satri360/vmuzero_seps525/README.md

# vmuzero_seps525
Dreamcast VMU powered by Raspberry Pi Zero Project
