satri360/vmuzero_seps525/vmuzero_SEPS525_V1_0_ICHG100.sch

## EAGLE design vmuzero_SEPS525_V1_0_ICHG100.sch (2018-01-29)

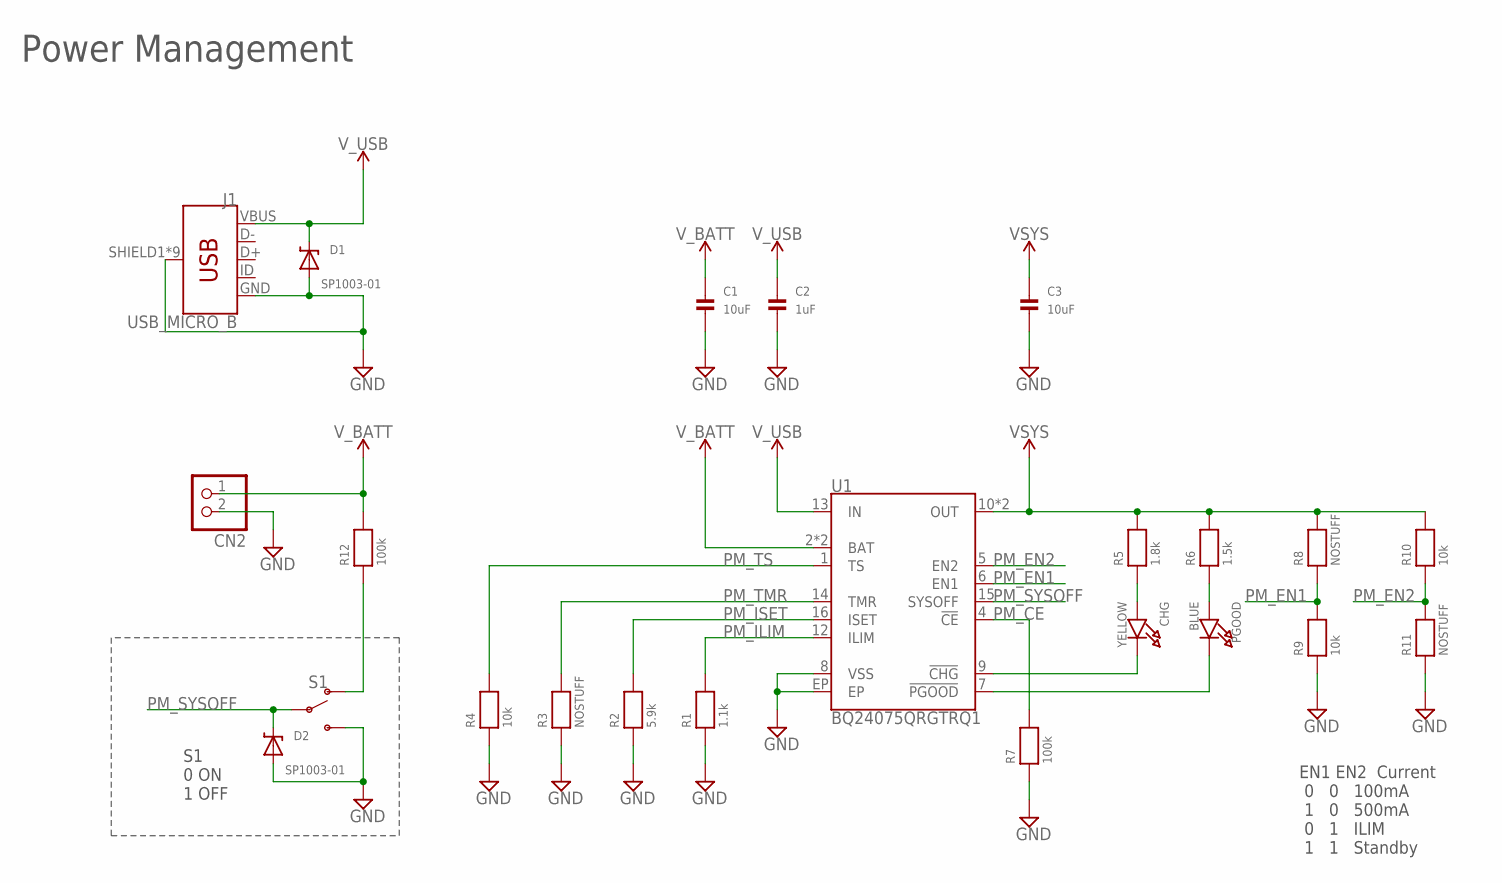
[picture p1: schematic vmuzero_SEPS525_V1_0_ICHG100.sch, sheet 1]

Parts:
C1, C3: 10uF; _0805MP
C2: 1uF; _0805MP
CHG: YELLOW; CHIPLED_0805_NOOUTLINE
CN2: JST_2PIN; S2B-PH-K-S
D1, D2: SP1003-01; DIODE_SOD723
J1: USB_MICRO_B; UJ2-MIBH2-4-SMT
PGOOD: BLUE; CHIPLED_0805_NOOUTLINE
R1: 1.1k; _0805MP
R2: 5.9k; _0805MP
R3, R8, R11: NOSTUFF; _0805MP
R4, R9, R10: 10k; _0805MP
R5: 1.8k; _0805MP
R6: 1.5k; _0805MP
R7, R12: 100k; _0805MP
S1: SWITCH-SPDT; SPDT_JS102011SAQN
U1: BQ24075QRGTRQ1; PVQFN-N16

Connections:
GND: C1.2, C2.2, C3.2, CN2.2 (1), D1.A, D2.A, J1.GND, J1.SHIELD1 (SHIELD), R1.1, R2.1, R3.1, R4.1, R7.1, R9.1, R11.1, S1.P$3 (S), U1.8 (VSS), U1.EP
unnamed: CHG.C, U1.9 (!CHG!)
unnamed: PGOOD.C, U1.7 (!PGOOD!)
unnamed: R12.1, S1.P$1 (O)
unnamed: PGOOD.A, R6.1
unnamed: CHG.A, R5.1
PM_CE: R7.2, U1.4 (!CE!)
PM_EN1: R8.1, R9.2, U1.6 (EN1)
PM_EN2: R10.1, R11.2, U1.5 (EN2)
PM_ILIM: R1.2, U1.12 (ILIM)
PM_ISET: R2.2, U1.16 (ISET)
PM_SYSOFF: D2.C, S1.P$2, U1.15 (SYSOFF)
PM_TMR: R3.2, U1.14 (TMR)
PM_TS: R4.2, U1.1 (TS)
VSYS: C3.1, R5.2, R6.2, R8.2, R10.2, U1.10 (OUT)
V_BATT: C1.1, CN2.1 (2), R12.2, U1.2 (BAT)
V_USB: C2.1, D1.C, J1.VBUS, U1.13 (IN)

Notes on the sheet:
Power Management
EN1 EN2 Current 0 0 100mA 1 0 500mA 0 1 ILIM 1 1 Standby
S1 0 ON 1 OFF

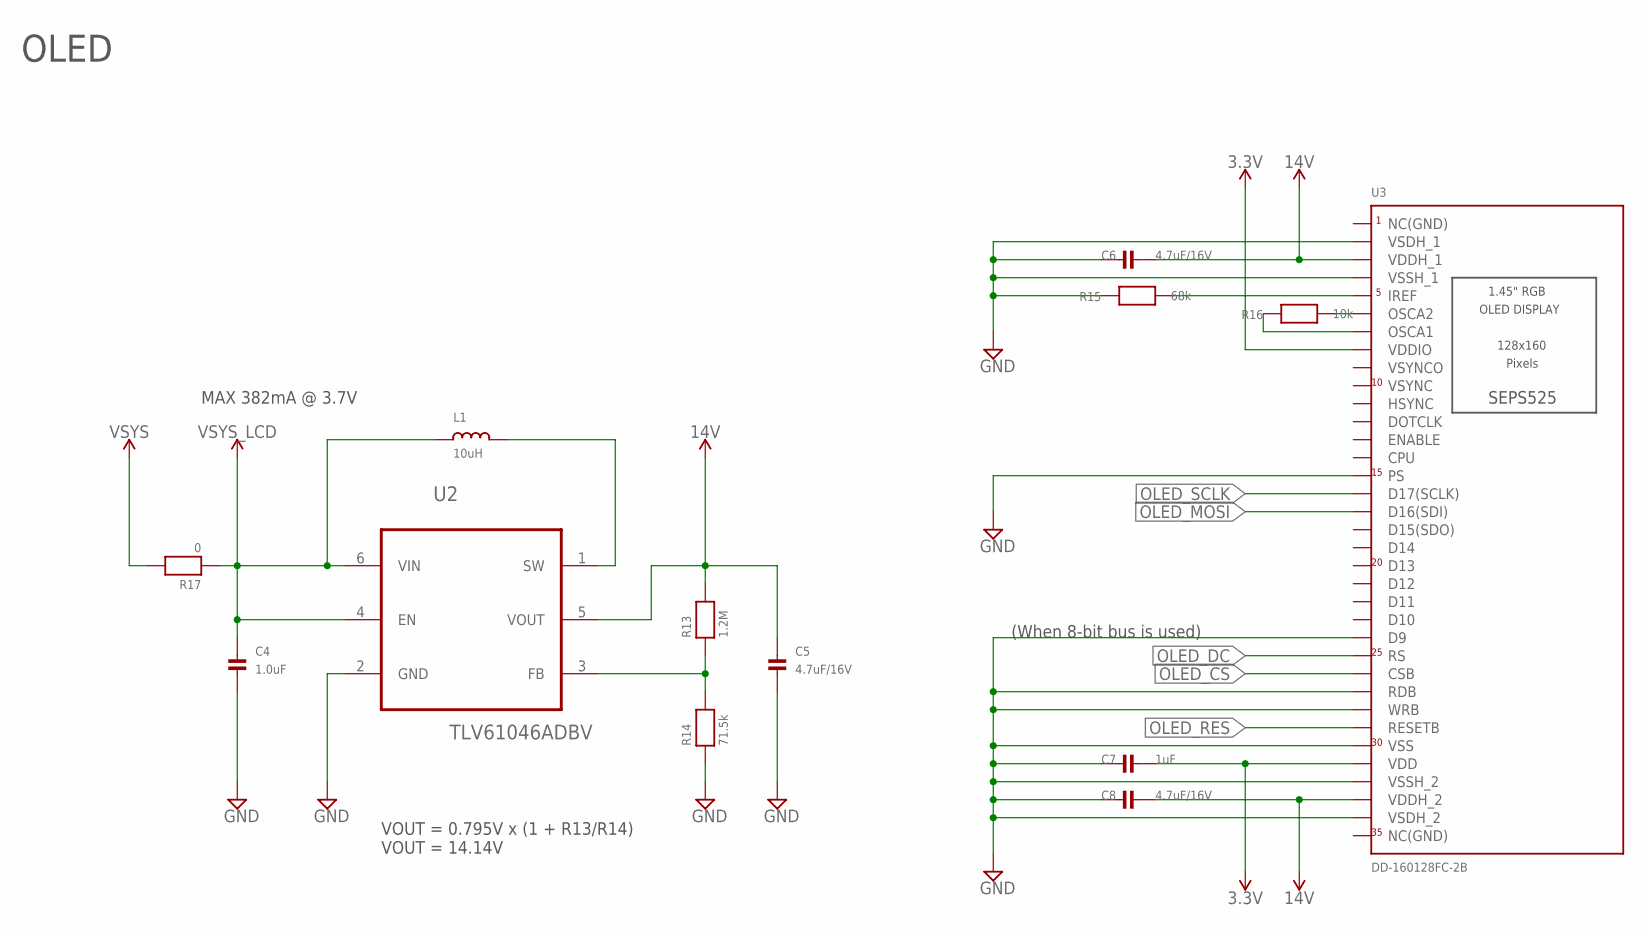
[picture p2: schematic vmuzero_SEPS525_V1_0_ICHG100.sch, sheet 2]

Parts:
C4: 1.0uF; _0805MP
C5, C6, C8: 4.7uF/16V; _0805MP
C7: 1uF; _0805MP
L1: 10uH; LQH2
R13: 1.2M; _0805MP
R14: 71.5k; _0805MP
R15: 68k; _0805MP
R16: 10k; _0805MP
R17: 0; _0805MP
U2: TLV61046ADBV; R-PDSO-G6
U3: DD-160128FC-2B; XF2M-3515-1A

Connections:
3.3V: C7.1, U3.8 (VDDIO), U3.31 (VDD)
14V: C5.1, C6.1, C8.1, R13.2, U2.5 (VOUT), U3.3 (VDDH_1), U3.33 (VDDH_2)
GND: C4.2, C5.2, C6.2, C7.2, C8.2, R14.1, R15.2, U2.2 (GND), U3.2 (VSDH_1), U3.4 (VSSH_1), U3.15 (PS), U3.24 (D9), U3.27 (RDB), U3.28 (WRB), U3.30 (VSS), U3.32 (VSSH_2), U3.34 (VSDH_2)
unnamed: R15.1, U3.5 (IREF)
unnamed: L1.P$2 (2), U2.1 (SW)
unnamed: R13.1, R14.2, U2.3 (FB)
unnamed: R16.1, U3.6 (OSCA2)
unnamed: R16.2, U3.7 (OSCA1)
OLED_CS: U3.26 (CSB)
OLED_DC: U3.25 (RS)
OLED_MOSI: U3.17 (D16(SDI))
OLED_RES: U3.29 (RESETB)
OLED_SCLK: U3.16 (D17(SCLK))
VSYS: R17.2
VSYS_LCD: C4.1, L1.P$1 (1), R17.1, U2.4 (EN), U2.6 (VIN)

Notes on the sheet:
OLED
VOUT = 0.795V x (1 + R13/R14) VOUT = 14.14V
(When 8-bit bus is used)
MAX 382mA @ 3.7V

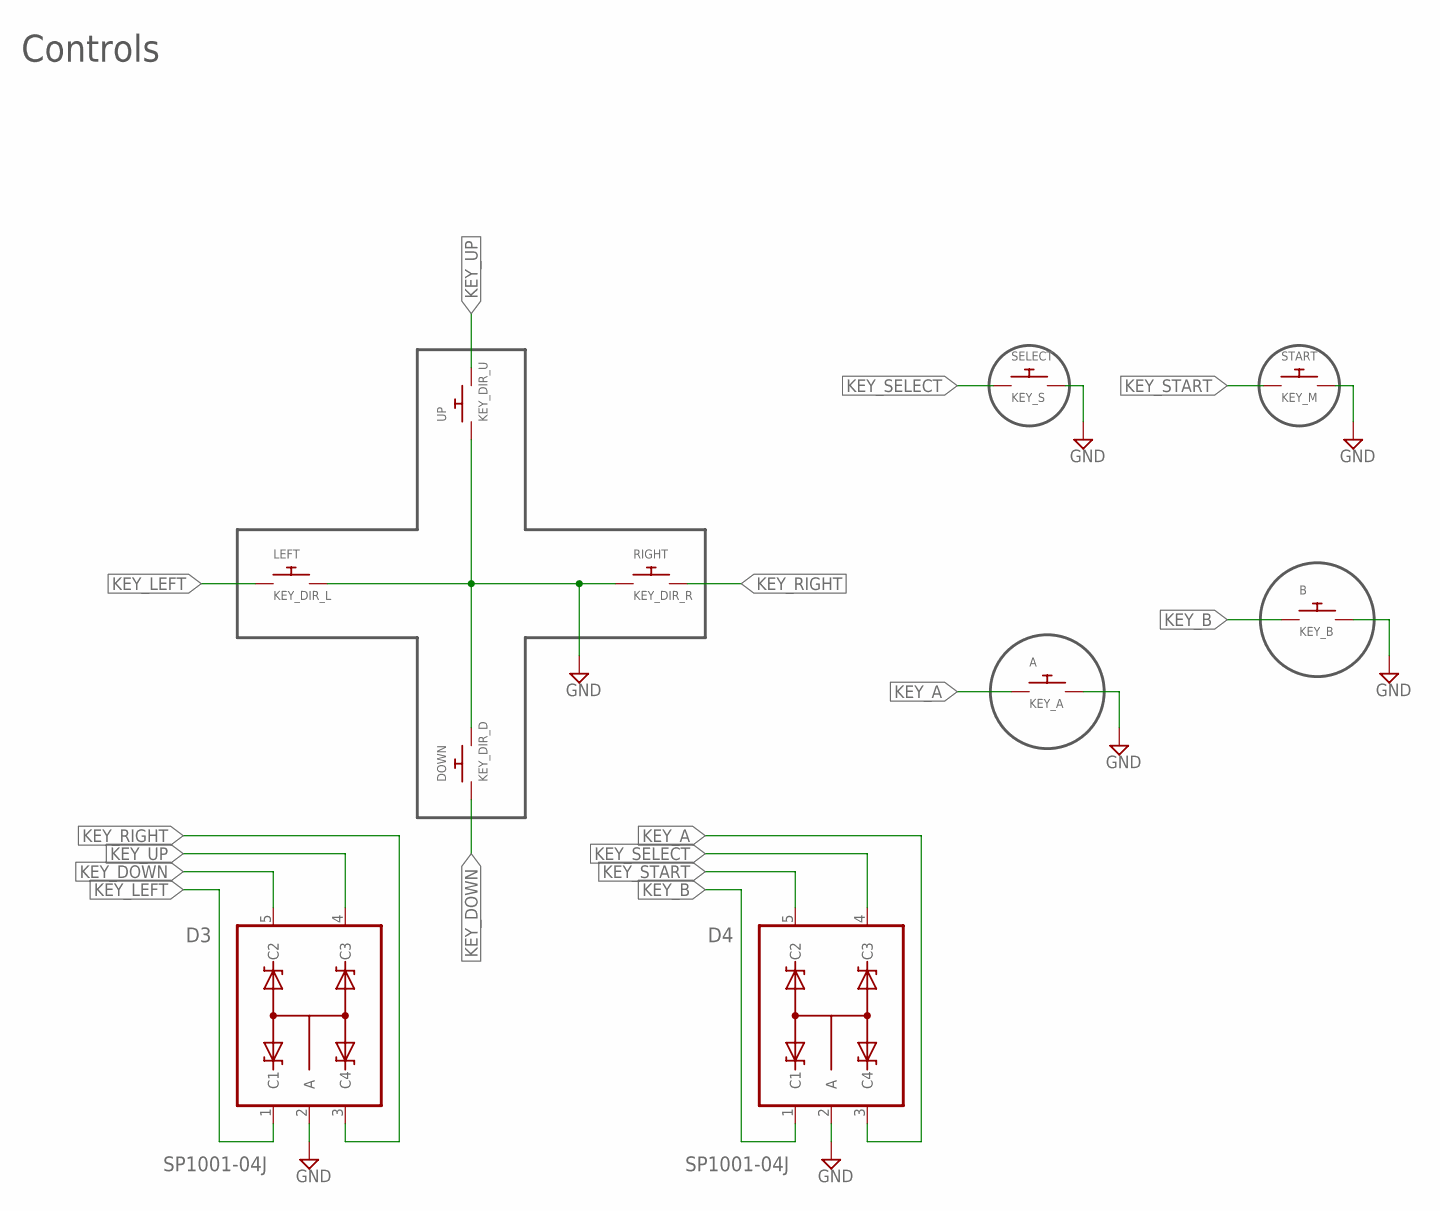
[picture p3: schematic vmuzero_SEPS525_V1_0_ICHG100.sch, sheet 3]

Parts:
A: KEY_A; KEYPAD_VMU_R26
B: KEY_B; KEYPAD_VMU_R26
D3, D4: SP1001-04J; SC70-5
DOWN: KEY_DIR_D; KEYPAD_VMU_R26
LEFT: KEY_DIR_L; KEYPAD_VMU_R26
RIGHT: KEY_DIR_R; KEYPAD_VMU_R26
SELECT: KEY_S; KEYPAD_VMU_R26
START: KEY_M; KEYPAD_VMU_R26
UP: KEY_DIR_U; KEYPAD_VMU_R26

Connections:
GND: A.2, B.2, D3.2 (A), D4.2 (A), DOWN.2, LEFT.2, RIGHT.1, SELECT.2, START.2, UP.1
KEY_A: A.1, D4.3 (C4)
KEY_B: B.1, D4.1 (C1)
KEY_DOWN: D3.5 (C2), DOWN.1
KEY_LEFT: D3.1 (C1), LEFT.1
KEY_RIGHT: D3.3 (C4), RIGHT.2
KEY_SELECT: D4.4 (C3), SELECT.1
KEY_START: D4.5 (C2), START.1
KEY_UP: D3.4 (C3), UP.2

Notes on the sheet:
Controls

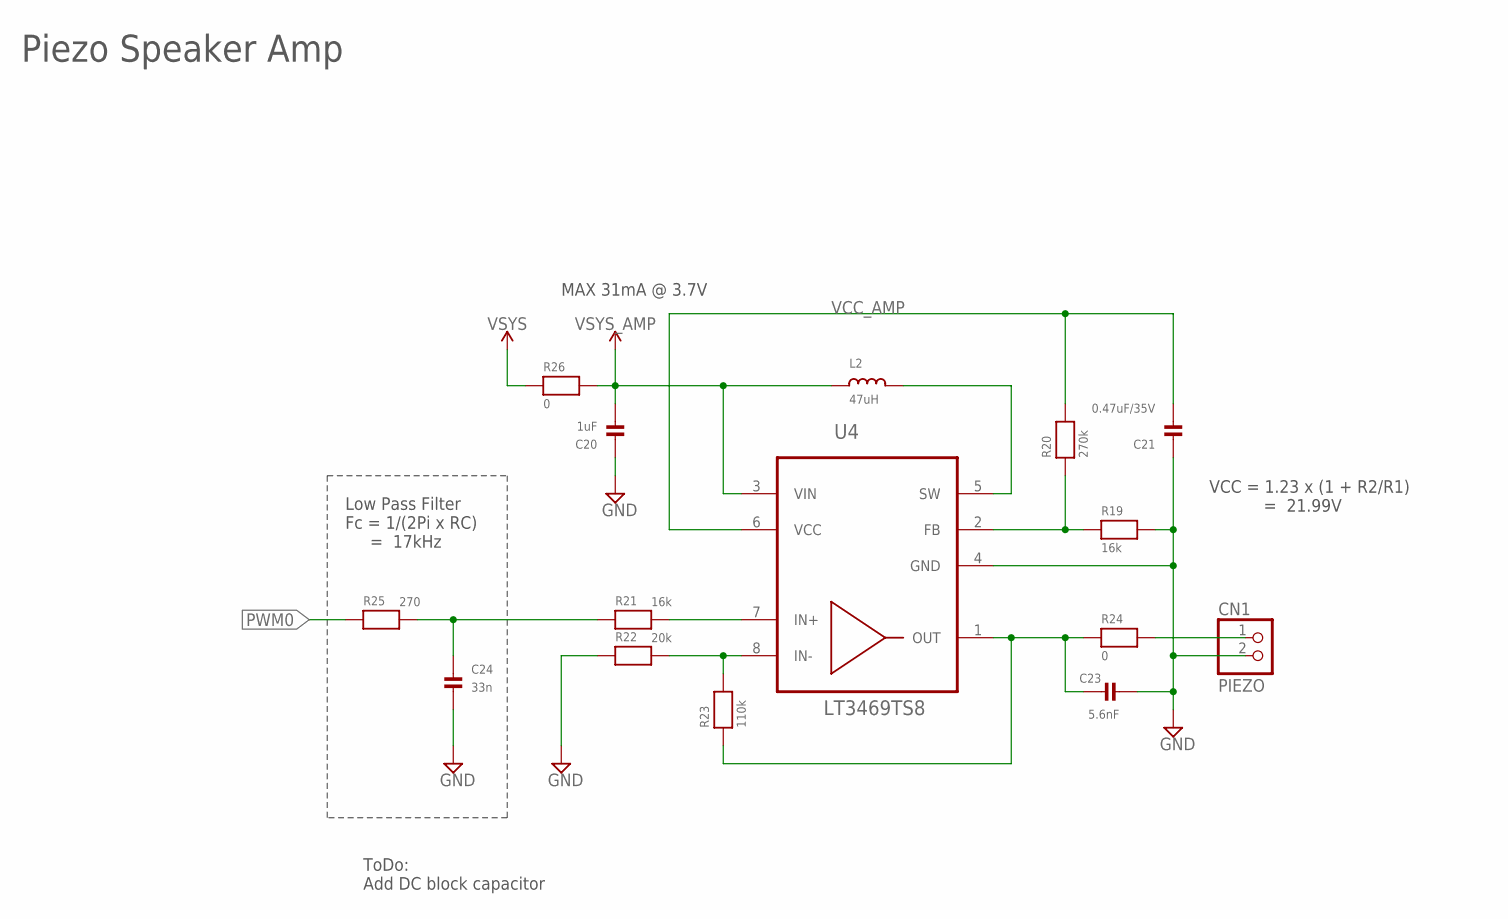
[picture p4: schematic vmuzero_SEPS525_V1_0_ICHG100.sch, sheet 4]

Parts:
C20: 1uF; _0805MP
C21: 0.47uF/35V; _0805MP
C23: 5.6nF; _0805MP
C24: 33n; _0805MP
CN1: PIEZO; 1X02_ROUND
L2: 47uH; LQH32C
R19, R21: 16k; _0805MP
R20: 270k; _0805MP
R22: 20k; _0805MP
R23: 110k; _0805MP
R24, R26: 0; _0805MP
R25: 270; _0805MP
U4: LT3469TS8; TSOT-23-8

Connections:
GND: C20.1, C21.1, C23.2, C24.2, CN1.2, R19.2, R22.1, U4.4 (GND)
unnamed: L2.P$2 (2), U4.5 (SW)
unnamed: R19.1, R20.1, U4.2 (FB)
unnamed: C23.1, R23.1, R24.1, U4.1 (OUT)
unnamed: R22.2, R23.2, U4.8 (IN-)
unnamed: CN1.1, R24.2
unnamed: C24.1, R21.1, R25.2
unnamed: R21.2, U4.7 (IN+)
PWM0: R25.1
VCC_AMP: C21.2, R20.2, U4.6 (VCC)
VSYS: R26.1
VSYS_AMP: C20.2, L2.P$1 (1), R26.2, U4.3 (VIN)

Notes on the sheet:
Piezo Speaker Amp
Low Pass Filter Fc = 1/(2Pi x RC) = 17kHz
VCC = 1.23 x (1 + R2/R1) = 21.99V
MAX 31mA @ 3.7V
ToDo: Add DC block capacitor

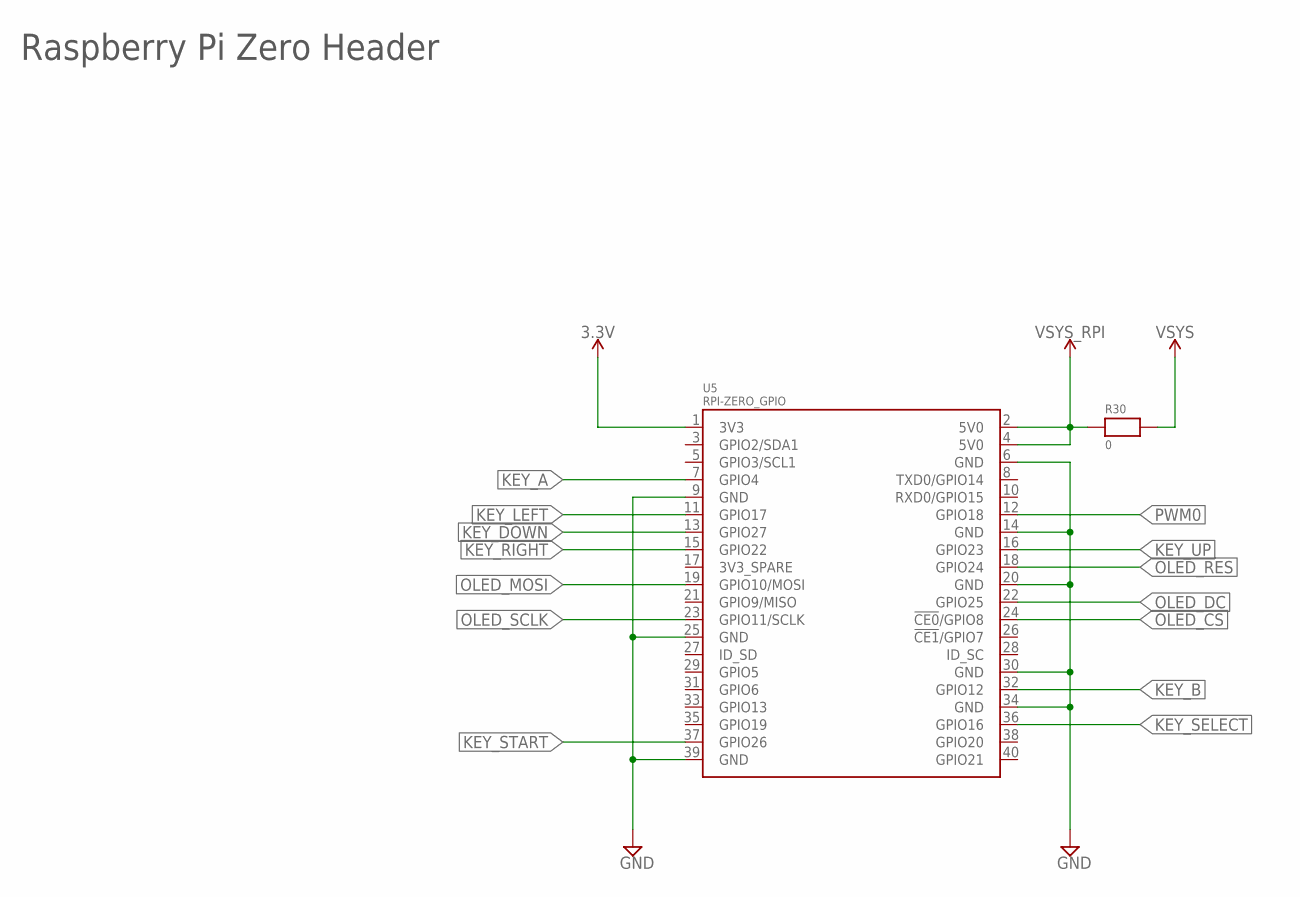
[picture p5: schematic vmuzero_SEPS525_V1_0_ICHG100.sch, sheet 5]

Parts:
R30: 0; _0805MP
U5: RPI-ZERO_GPIO; RASP_PI_ZERO_GPIO_SMD

Connections:
3.3V: U5.1 (3V3)
GND: U5.6 (GND), U5.9 (GND), U5.14 (GND), U5.20 (GND), U5.25 (GND), U5.30 (GND), U5.34 (GND), U5.39 (GND)
KEY_A: U5.7 (GPIO4)
KEY_B: U5.32 (GPIO12)
KEY_DOWN: U5.13 (GPIO27)
KEY_LEFT: U5.11 (GPIO17)
KEY_RIGHT: U5.15 (GPIO22)
KEY_SELECT: U5.36 (GPIO16)
KEY_START: U5.37 (GPIO26)
KEY_UP: U5.16 (GPIO23)
OLED_CS: U5.24 (!CE0!/GPIO8)
OLED_DC: U5.22 (GPIO25)
OLED_MOSI: U5.19 (GPIO10/MOSI)
OLED_RES: U5.18 (GPIO24)
OLED_SCLK: U5.23 (GPIO11/SCLK)
PWM0: U5.12 (GPIO18)
VSYS: R30.2
VSYS_RPI: R30.1, U5.2 (5V0), U5.4 (5V0)

Notes on the sheet:
Raspberry Pi Zero Header
