satri360/vmuzero_seps525/(commit log)

2018-02-24 Add files via upload
    Changed R6 to 1.5kΩ to reduce brightness of the blue LED
2018-10-07 V2 prototype
    [vmuzero_SEPS525_V1_0_ICHG100.brd, vmuzero_SEPS525_V1_8_1.brd, vmuzero_SEPS525_V1_8_1.sch]
2018-11-04 SEPS525 FBTFT Driver for RetroPie-4.3 Kernel 4.9.35+
    [vmuzero_SEPS525_V1_8_1.brd, vmuzero_SEPS525_V1_8_1.sch]
2018-11-04 SEPS525 FBTFT Driver for RetroPie-4.4 Kernel 4.14.30+
